neko1000nin/tws_lp_jis60_trackball/hardware/step/trackball_dock_assembly.step

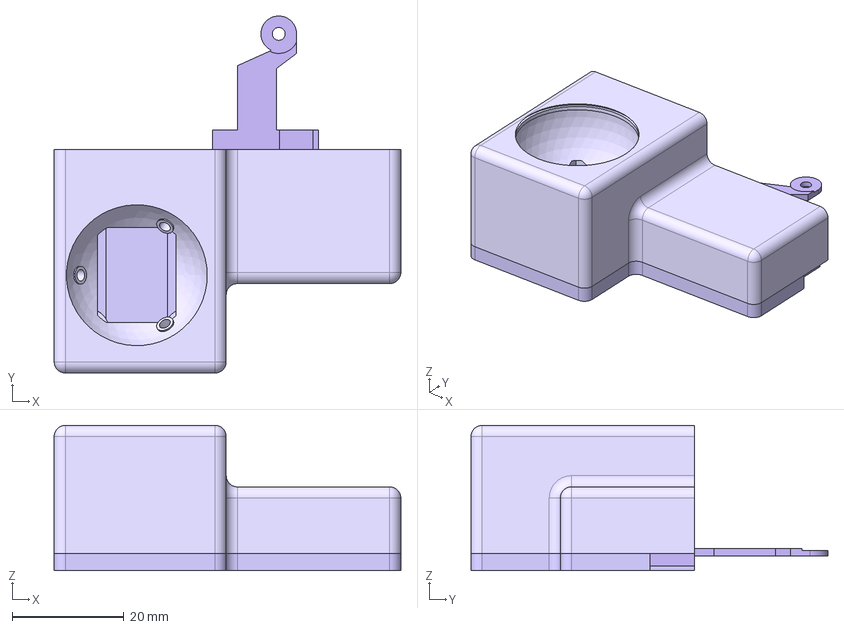
[picture p3: CAD file, 2026-10-11]
hardware/step/trackball_dock_assembly.step
62.0 x 63.9 x 26.0 mm
A_bracket
B_upper_body
C_bottom_plate
