neko1000nin/tws_lp_jis60_trackball/hardware/stl/A_bracket.stl

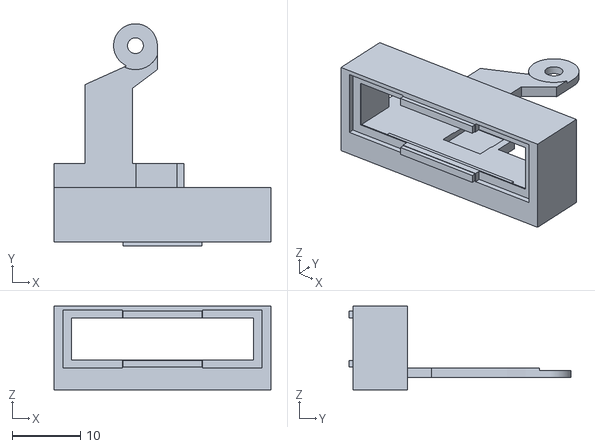
[picture p4: CAD file, 2026-10-11]
hardware/stl/A_bracket.stl
31.7 x 32.5 x 12.2
