neko1000nin/tws_lp_jis60_trackball/hardware/stl/C_bottom_plate.stl

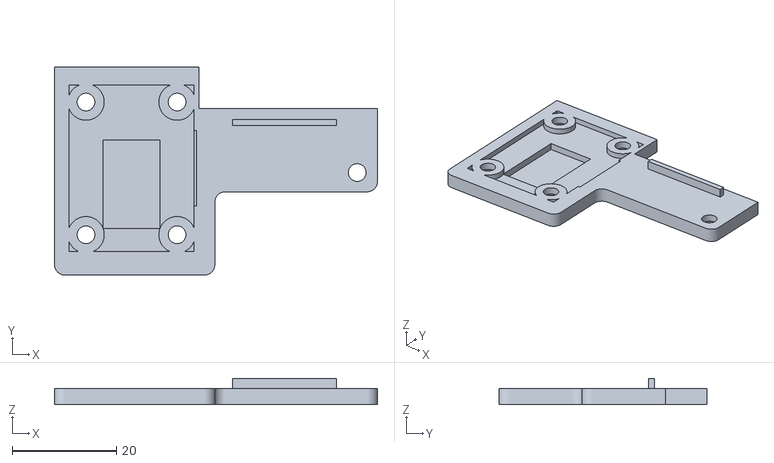
[picture p5: CAD file, 2026-10-11]
hardware/stl/C_bottom_plate.stl
62.1 x 40.0 x 5.00
