neko1000nin/tws_lp_jis60_trackball/hardware/stl/B_upper_body.stl

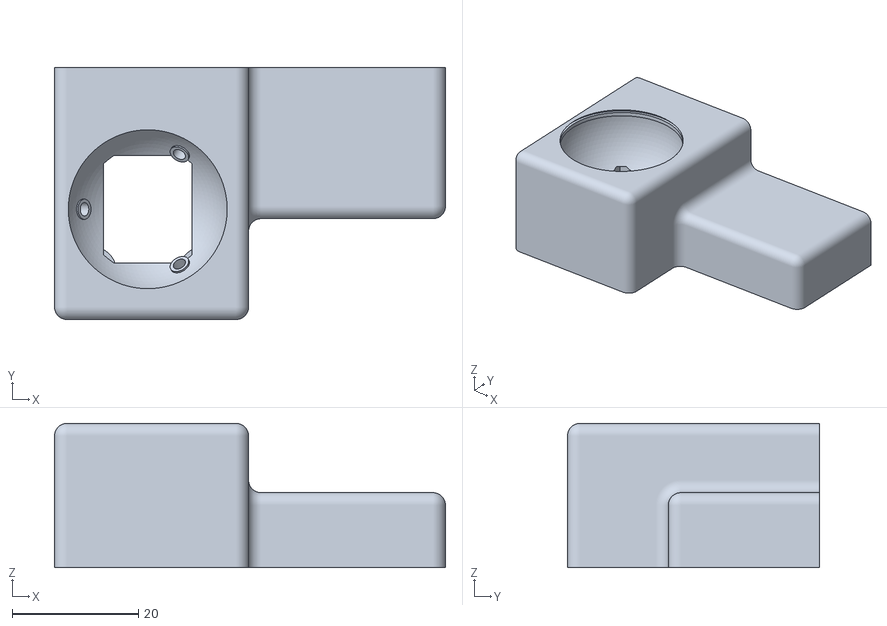
[picture p6: CAD file, 2026-10-11]
hardware/stl/B_upper_body.stl
62.1 x 40.0 x 22.9
