neko1000nin/tws_lp_jis60_trackball/(commit log)

2026-10-11 Add PMW3610 trackball support to the right half (v1.0)
    - Add badjeff/zmk-pmw3610-driver (zmk-0.3 branch, pinned) to west.yml
    - Right half: PMW3610 on spi2 with SDIO=D8, SCLK=D9, nCS=D10, MOTION=NFC1
    (NFC pins switched to GPIO via &uicr nfct-pins-as-gpios)
    - trackball_config.h: single place for wiring, CPI, scaling and orientation
    (verified on hardware: TB_SWAP_XY=1, TB_INVERT_X=1, TB_INVERT_Y=1, CPI 600)
    - Cursor movement only; keymap is unchanged from upstream
    - build.sh: one-command local build with Docker (right/left/reset/debug/probe)
    - src/tb_pin_probe.c: wiring/optics diagnostic firmware, only built by
    `./build.sh probe`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
    [tb_pin_probe.c, trackball_config.h]
2026-10-11 Add mouse/custom layers, BLE profile isolation and hardware docs (v1.1)
    Keymap
    - Mouse layer: hold-preferred Mouse Layer-Tap on ':' and EISU (INT5);
    U/I/O scroll left/up/right, J/K/L click/scroll down/right click,
    M/,/. MB4/middle/MB5. Scroll macros are Studio-assignable.
    - Custom layer (Android/iPad): Ctrl-morphed Emacs-style keys
    (A=Home, E=End, P/N/F/B=arrows, H=BSpace, D=Delete, S=Ctrl+F,
    ;=Enter). Fn+Fn+X enters, Fn+Fn+Z returns to Default.
    - Layer order Default/Lower/Custom/Mouse/Adjust so Fn and mouse keys
    keep working in Custom mode.
    - Fn+Fn+Q..T select a BLE profile and disconnect the others.
    Bluetooth (experimental, local builds only)
    - patches/zmk-ble-adv-filter-active-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
    [A_bracket.stl, B_upper_body.stl, C_bottom_plate.stl, trackball_dock_assembly.step]
